AliouneDiouf/MyoCoach/image/arduino_uno.jpg

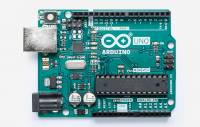
image/arduino_uno.jpg
