AliouneDiouf/MyoCoach/image/Capture2.PNG

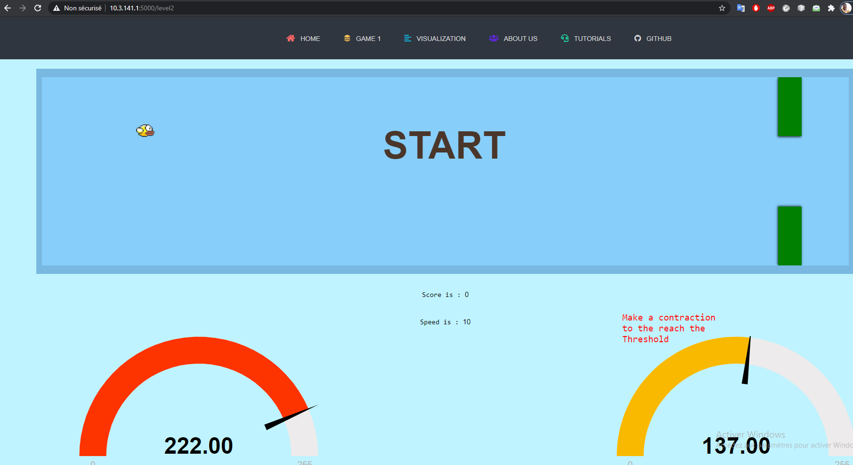
image/Capture2.PNG
