AliouneDiouf/MyoCoach/image/connexion_boitier_ordi.png

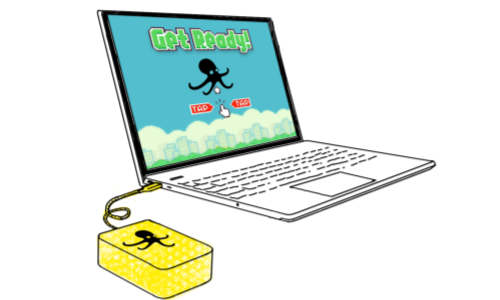
image/connexion_boitier_ordi.png
