AliouneDiouf/MyoCoach/image/emg_0_emg_1.png

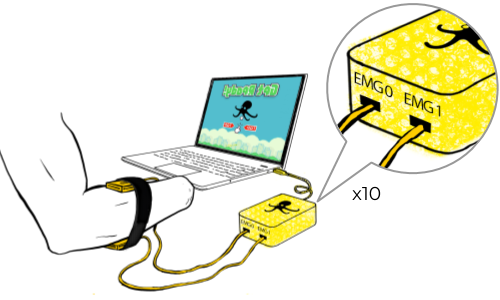
image/emg_0_emg_1.png
