AliouneDiouf/MyoCoach/image/general_view.png

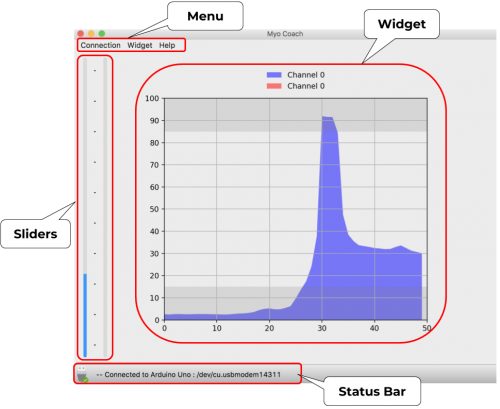
image/general_view.png
