AliouneDiouf/MyoCoach/image/home.PNG

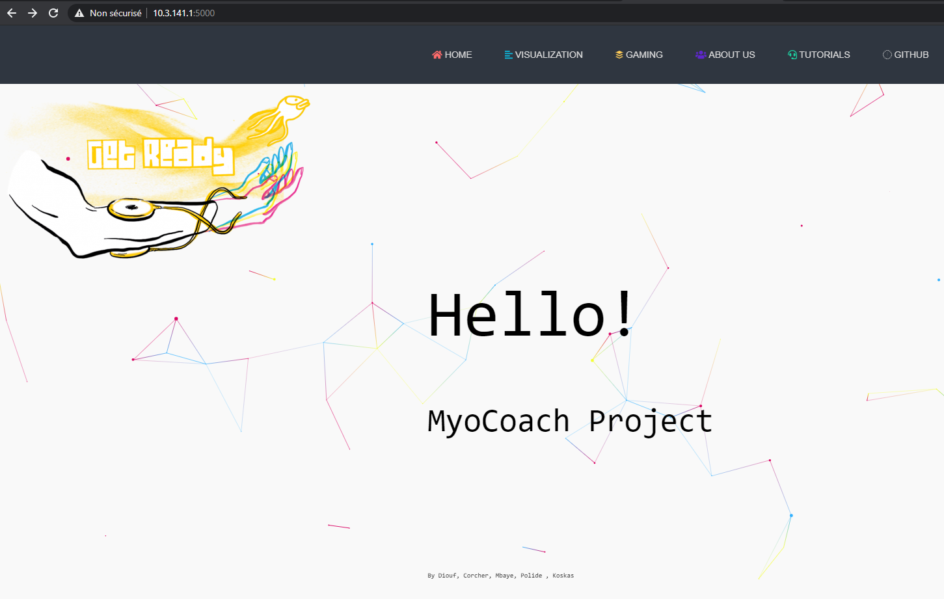
image/home.PNG
