AliouneDiouf/MyoCoach/image/insta.PNG

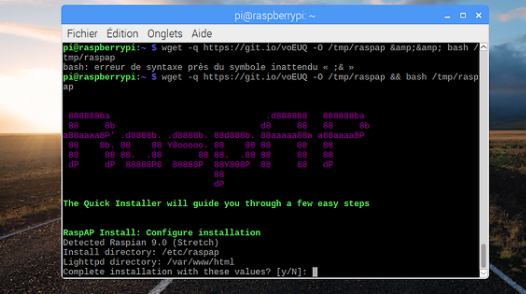
image/insta.PNG
