AliouneDiouf/MyoCoach/image/materiel_pre-requis.png

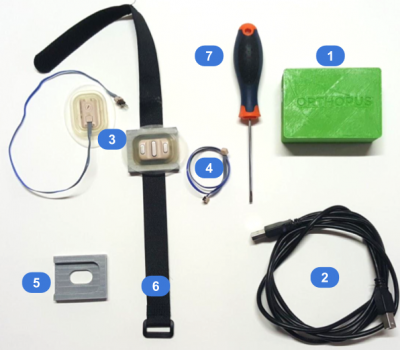
image/materiel_pre-requis.png
