AliouneDiouf/MyoCoach/image/myocoach.png

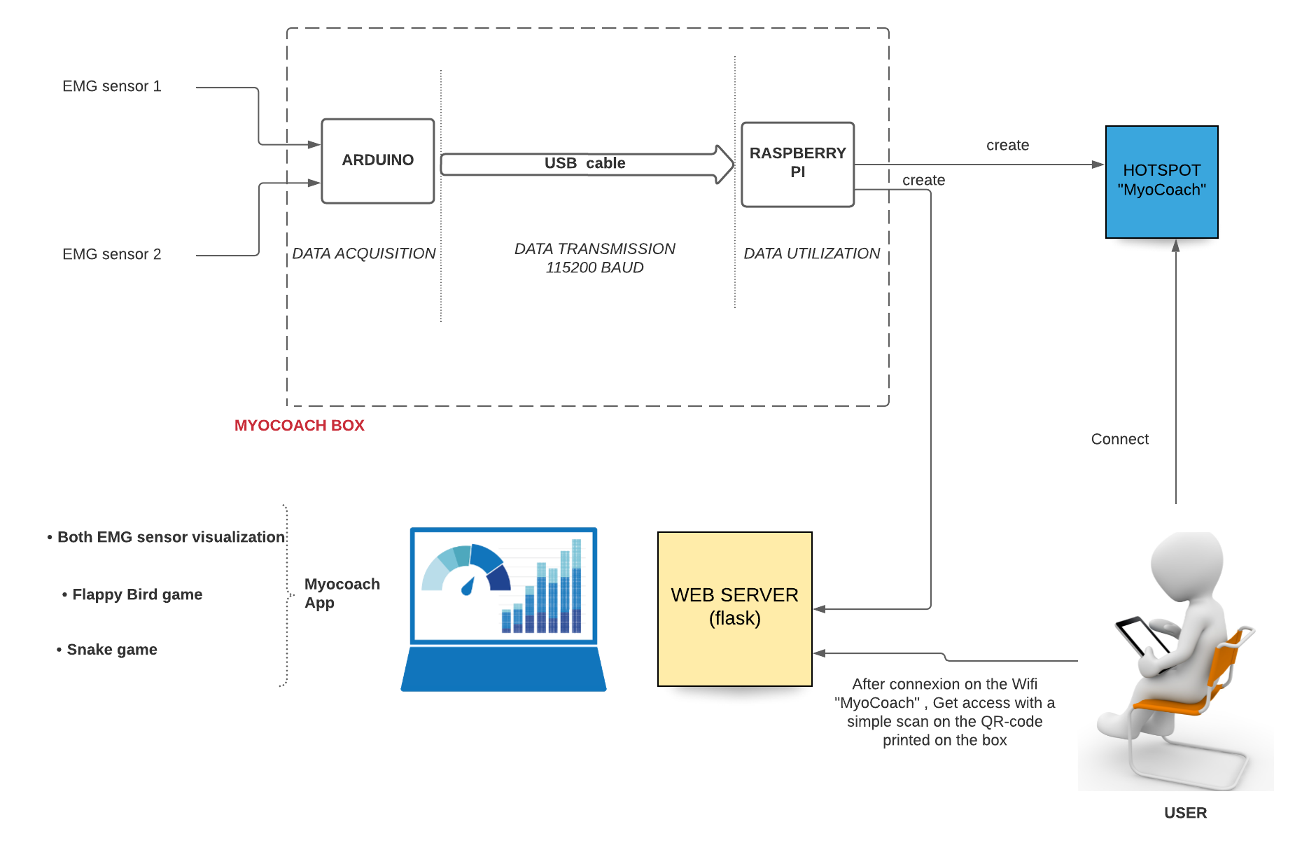
image/myocoach.png
