AliouneDiouf/MyoCoach/image/record_bionico.png

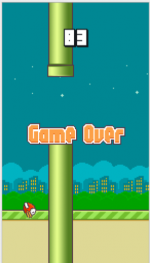
image/record_bionico.png
