AliouneDiouf/MyoCoach/image/screenshot_flappybird.png

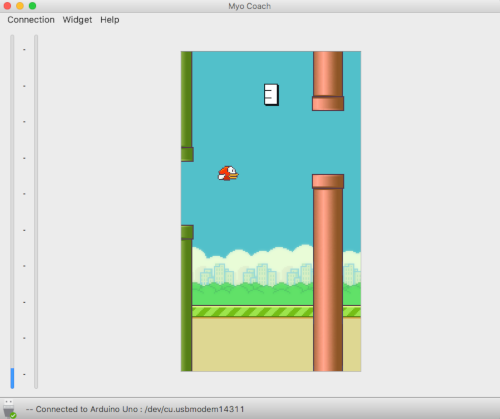
image/screenshot_flappybird.png
