AliouneDiouf/MyoCoach/image/screenshot_signal.png

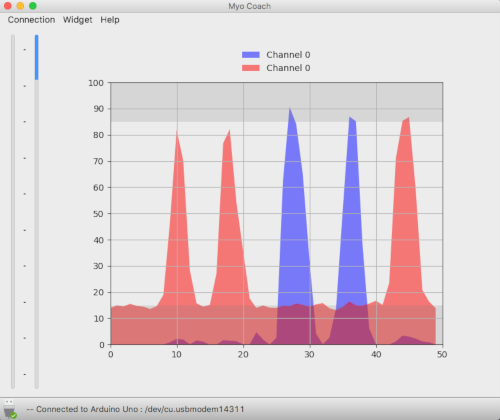
image/screenshot_signal.png
