AliouneDiouf/MyoCoach/image/serious.PNG

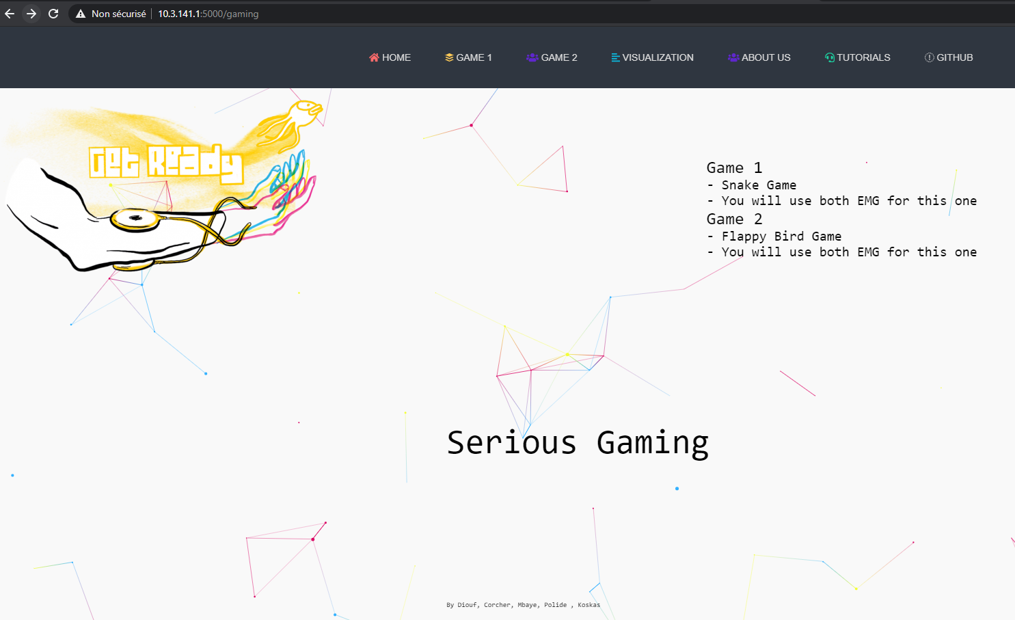
image/serious.PNG
