AliouneDiouf/MyoCoach/image/sliders.png

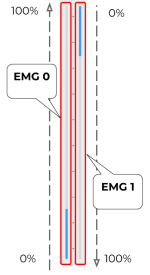
image/sliders.png
