AliouneDiouf/MyoCoach/static/back2.png

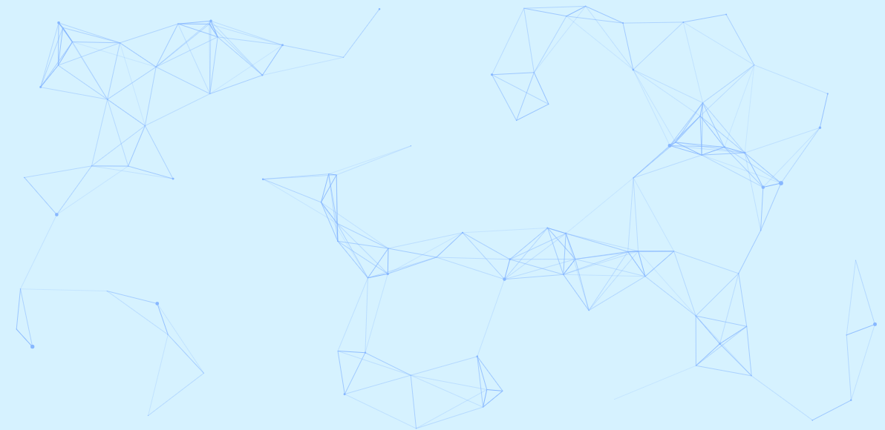
static/back2.png
