AliouneDiouf/MyoCoach/static/back3.png

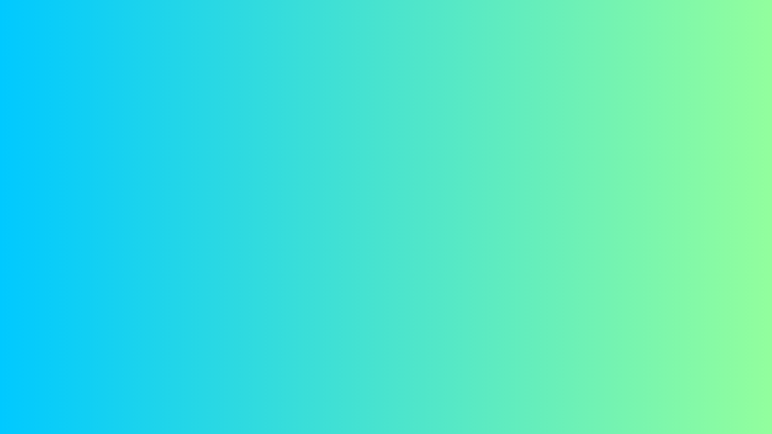
static/back3.png
