AliouneDiouf/MyoCoach/static/back4.png

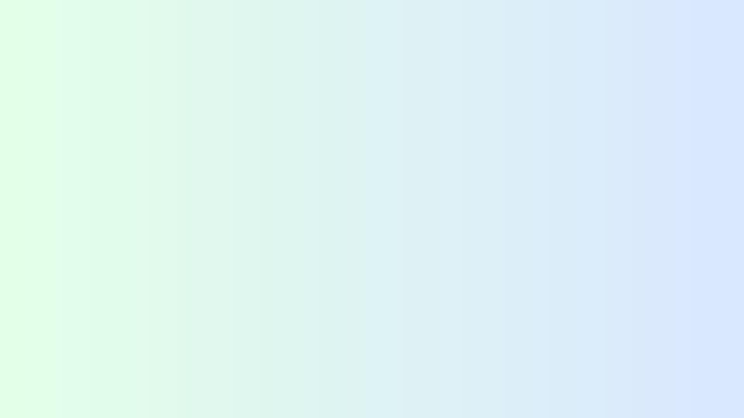
static/back4.png
