AliouneDiouf/MyoCoach/static/back5.png

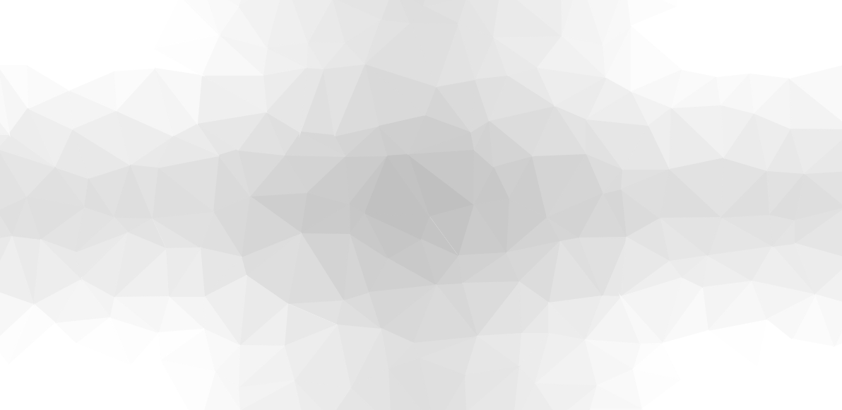
static/back5.png
