AliouneDiouf/MyoCoach/static/back6.png

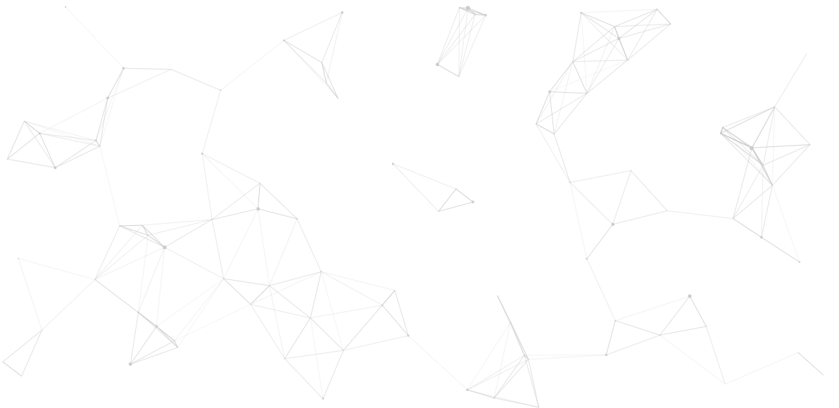
static/back6.png
