AliouneDiouf/MyoCoach/static/back7.png

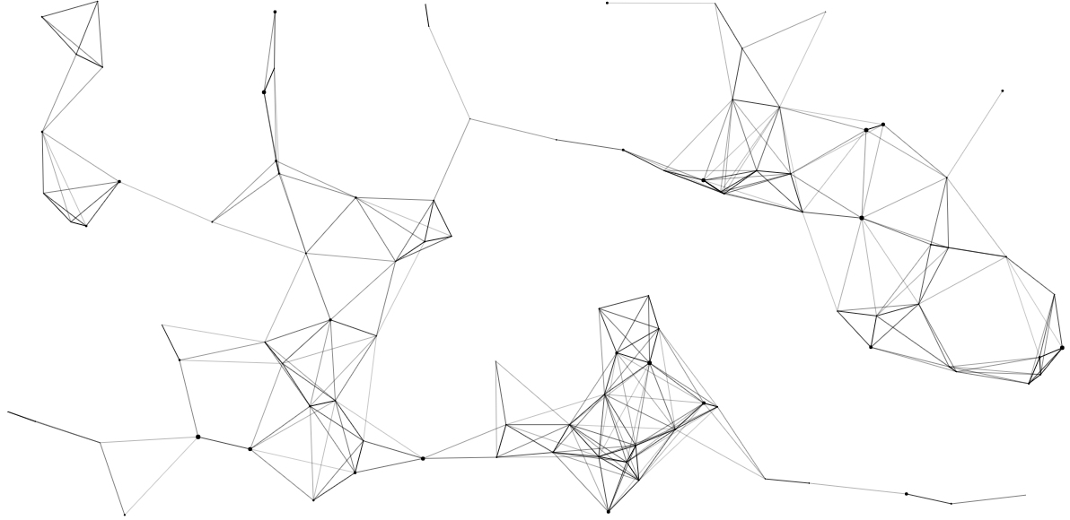
static/back7.png
