AliouneDiouf/MyoCoach/static/css/pic.jpg

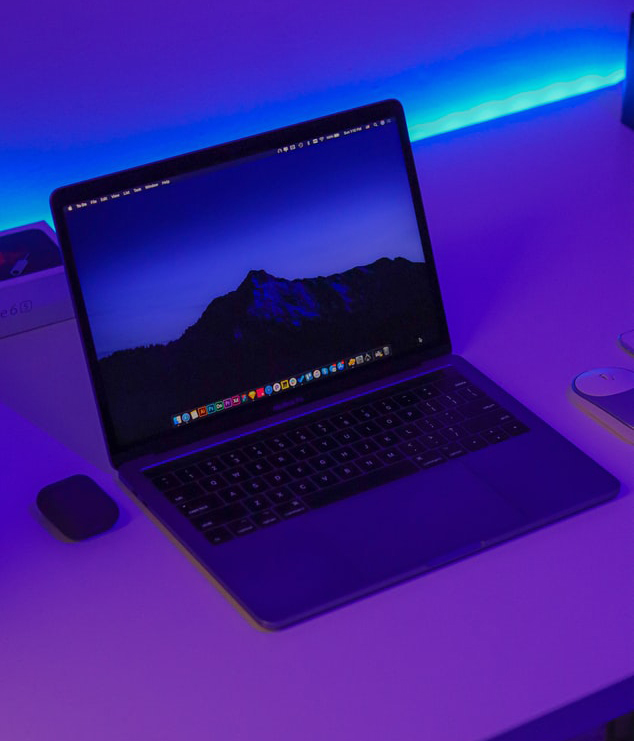
static/css/pic.jpg
