AliouneDiouf/MyoCoach/cost.md

# 0113-MyoCoach-DIY :<br>Price Transparency

## Raw Material Price
| Description | Quantity | Unit Price | Price |
| --- | --- | --- | --- |
| Raspberry Pi 3b+ | 1 | 37.03€ | 37.03€ |
| Sensor Support (3D print)| 2 | 0.60€ | 1.20€ |
| Box Casing (3D print)| 1 | 2.18€ | 2.18€ |
| Arduino Board Uno | 1 | 20.00€ | 20.00€ |
| female pin header strip | 1 | 1.17€ | 1.17€ |
| male pin header strip | 1 | 1.07€ | 1.07€ |
| Self-tapping screws | 8 | 0.02€ | 0.16€ |
| strap with velcro and buckle | 1 | 0.50€ | 0.50€ |
| set of electronic cables | 1 | 2.68€ | 2.68 € |
| | | **Total** | **65.99€** |
